LokiResearch/LagMeterUIST17/Readme.md

# Description

## electronicBoard

Contains the Eagle files to replicate the lagmeter shield for Arduino Leonardo.

A [shopping basket](http://www.digikey.fr/short/qtt791) with the list of components to buy is ready for Digikey (also available as a [CSV file](electronicBoard/digikey.csv)).

## LagmeterLeonardo

Contains the Arduino code to run on an Arduino Leonardo board with the above shield.

Requires to install [HID-Project](https://github.com/NicoHood/HID/) first.

## TurboHID

Contains C++ source code to communicate with the Arduino Leonardo using raw HID.

You have to install [libpointing](http://libpointing.org) first (used for the timestamps).

To compile the library run ```qmake && make```

On Windows, the library is provided in the external folder.

## BasicLogger

Code for logging data coming from the Arduino

Successfully compile using Qt 5.15.1 MSCV2015 64 bits in release mode.

## ReplicationCppQt && ReplicationCppGLUT

Code for producing tables 4, 5 & 6 in the paper. Compile using ```qmake && make```

Edit ```config.cfg``` to provide the URI for your mouse.

Directly pass the config file as a parameter for the GLUT application and use ```-c config.cfg``` for the Qt application.

## parser

Python code to parse the log files and compute stats.

Example: ```./parse-log --start piezo yourlogfile```

You have to correct the reported values according to what is described in the paper: "Intermediate latency values were computed by subtracting the host computer piezo time from the considered event time (libpointing, system, toolkit, repaint or screen), adding 5.7 ms and further adding 0.7 ms for the initial communication between the Arduino and the host computer." (page 5). Read the paper for more details.

## FlashApps

Code for producing Table 7 in the paper.

## UISTdemo

Android code used for the UIST demo showing the measure of latency while the user is interacting with an application. The lagmeter is connected to the Android device.

## Related publication



```
@inproceedings{10.1145/3126594.3126606,
    author = {Casiez, G\'{e}ry and Pietrzak, Thomas and Marchal, Damien and Poulmane, S\'{e}bastien and Falce, Matthieu and Roussel, Nicolas},
    title = {Characterizing Latency in Touch and Button-Equipped Interactive Systems},
    year = {2017},
    isbn = {9781450349819},
    publisher = {Association for Computing Machinery},
    address = {New York, NY, USA},
    url = {https://doi.org/10.1145/3126594.3126606},
    doi = {10.1145/3126594.3126606},
    abstract = {We present a low cost method to measure and characterize the end-to-end latency when using a touch system (tap latency) or an input device equipped with a physical button. Our method relies on a vibration sensor attached to a finger and a photo-diode to detect the screen response. Both are connected to a micro-controller connected to a host computer using a low-latency USB communication protocol in order to combine software and hardware probes to help determine where the latency comes from. We present the operating principle of our method before investigating the main sources of latency in several systems. We show that most of the latency originates from the display side. Our method can help application designers characterize and troubleshoot latency on a wide range of interactive systems.},
    booktitle = {Proceedings of the 30th Annual ACM Symposium on User Interface Software and Technology},
    pages = {29–39},
    numpages = {11},
    keywords = {toolkits, measurement tools, measure, latency, lag},
    location = {Qu\'{e}bec City, QC, Canada},
    series = {UIST '17}
}
```
