LokiResearch/LagMeterUIST17/electronicBoard/digikey.csv

Index | Quantité | Référence | Description | Référence client | Quantité disponible | Quantité d'articles différés | Prix unitaire EUR | Montant EUR
1 | 2 | PTV09A-4020F-B103-ND | POT 10K OHM 1/20W CARBON LINEAR |  | 2 | 0 | 0 | 70000 | 1 | 40
2 | 1 | 1568-1413-ND | ARDUINO STACKABLE HEADER KIT - R |  | 1 | 0 | 1 | 27000 | 1 | 27
3 | 2 | 296-1388-5-ND | IC DIFF COMP W/STROBE 8-SOIC |  | 2 | 0 | 0 | 47000 | 0 | 94
4 | 2 | MMBT2907ALT1GOSCT-ND | TRANS PNP 60V 0.6A SOT23 |  | 2 | 0 | 0 | 09000 | 0 | 18
5 | 2 | 160-1167-1-ND | LED RED CLEAR 1206 SMD | D1_2 | 2 | 0 | 0 | 31000 | 0 | 62
6 | 2 | 160-1169-1-ND | LED GREEN CLEAR 1206 SMD | D3_4 | 2 | 0 | 0 | 29000 | 0 | 58
7 | 1 | 311-100GRCT-ND | RES SMD 100 OHM 5% 1/10W 0603 | R12 | 1 | 0 | 0 | 08000 | 0 | 08
8 | 4 | 445-7534-1-ND | CAP CER 0.1UF 50V X7R 0805 |  | 4 | 0 | 0 | 10000 | 0 | 40
9 | 1 | EG1903-ND | SWITCH SLIDE SPDT 200MA 30V |  | 1 | 0 | 0 | 49000 | 0 | 49
10 | 2 | S7000-ND | CONN HEADER FEMALE 2POS .1" TIN |  | 2 | 0 | 0 | 27000 | 0 | 54
11 | 1 | 1050-1040-ND | ARDUINO LEONARDO WITH HEADERS |  | 1 | 0 | 17 | 50000 | 17 | 50
12 | 1 | PDB-C156-ND | PHOTODIODE BLUE 8.02MM SQ CLEAR |  | 1 | 0 | 1 | 43000 | 1 | 43
13 | 1 | MSP6915-ND | SENSOR MINISENSE 100 VERTICAL |  | 1 | 0 | 4 | 90000 | 4 | 90
