LokiResearch/LagMeterUIST17/electronicBoard/lagmeter-complete.brd

## EAGLE design electronicBoard/lagmeter-complete.brd (2025-10-16)

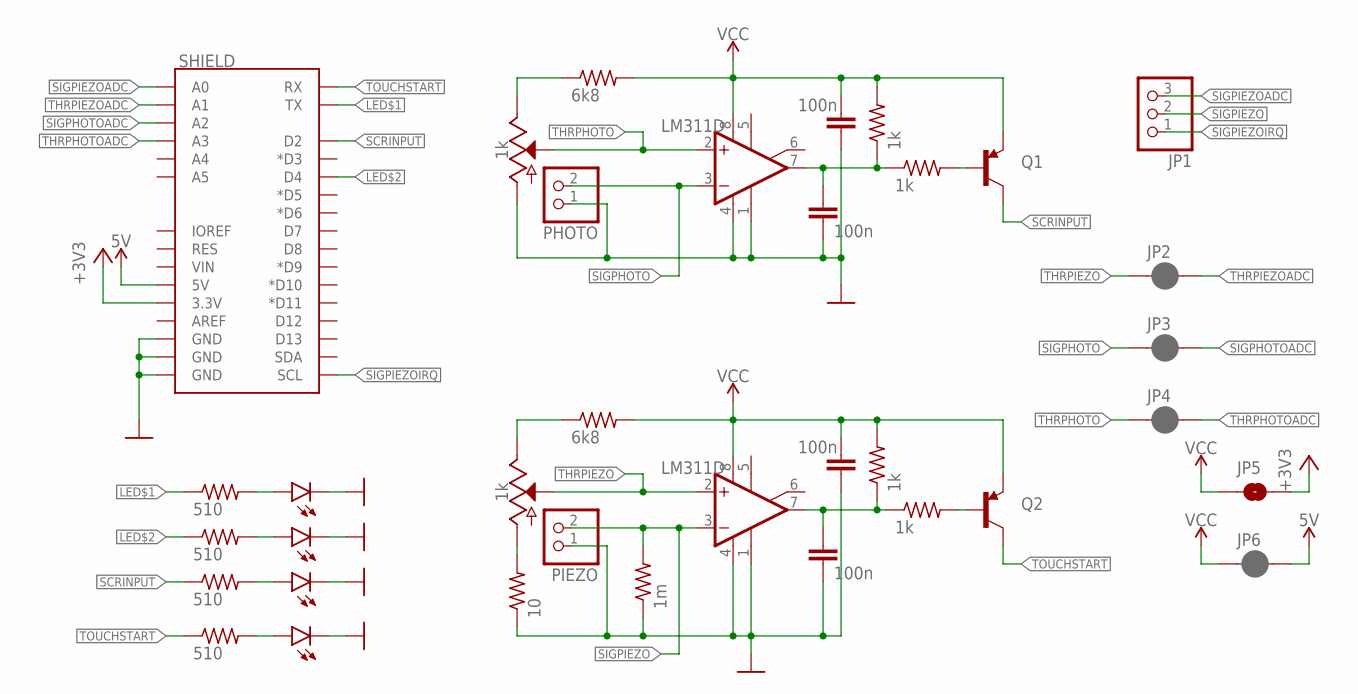
[picture p1: schematic lagmeter-complete.sch]

Parts:
C1, C2, C3, C4: 100n; C0805
D1, D2, D3, D4: LED1206; LED-1206
IC1, IC2: LM311D; SO08
JP1: PINHD-1X3; 1X03
JP2, JP3, JP4: JUMPER-SMT_2_NC_PASTE_SILK; SMT-JUMPER_2_NC_PASTE_SILK
JP5: JUMPER-SMT_2_NO_NO-SILK; SMT-JUMPER_2_NO_NO-SILK
JP6: JUMPER-SMT_2_NC_PASTE_NO-SILK; SMT-JUMPER_2_NC_PASTE_NO-SILK
PHOTO: PINHD-1X2; 1X02
PIEZO: PINHD-1X2; 1X02
Q1, Q2: TRANSISTOR_PNPSMD; SOT23-3
R1, R2: 6k8; R0603
R3, R4, R5, R6: 1k; R0603
R7, R8, R9, R10: 510; R0603
R11: 1m; R0603
R12: 10; R0603
SHIELD: ARDUINO_UNO_R3_SHIELDBASIC; UNO_R3_SHIELD
VR1, VR2: 1k; POT-PTH-ALPS

Connections:
5V: JP6.2, SHIELD.5V
+3V3: JP5.2, SHIELD.3.3V
GND: C1.2, C2.2, C3.2, C4.2, D1.C, D2.C, D3.C, D4.C, IC1.1 (GND), IC1.4 (V-), IC2.1 (GND), IC2.4 (V-), PHOTO.1, PIEZO.1, R11.1, R12.1, SHIELD.GND@0 (GND), SHIELD.GND@1 (GND), SHIELD.GND@2 (GND), VR1.P$3 (A)
LED$1: R9.1, SHIELD.TX
LED$2: R7.1, SHIELD.D4
MAXTHR: R2.1, VR2.P$1 (E)
MINTHR: R12.2, VR2.P$3 (A)
unnamed: D1.A, R9.2
unnamed: C2.1, IC1.7 (OUT), R3.1, R4.1
unnamed: D2.A, R7.2
unnamed: D3.A, R8.2
unnamed: Q1.1 (B), R3.2
unnamed: C4.1, IC2.7 (OUT), R5.1, R6.1
unnamed: Q2.1 (B), R5.2
unnamed: D4.A, R10.2
REFPHOTO: R1.1, VR1.P$1 (E)
SCRINPUT: Q1.3 (C), R8.1, SHIELD.D2
SIGPHOTO: IC1.3 (-IN), JP3.1, PHOTO.2
SIGPHOTOADC: JP3.2, SHIELD.A2
SIGPIEZO: IC2.3 (-IN), JP1.2, PIEZO.2, R11.2
SIGPIEZOADC: JP1.3, SHIELD.A0
SIGPIEZOIRQ: JP1.1, SHIELD.SCL
THRPHOTO: IC1.2 (+IN), JP4.1, VR1.P$2 (S)
THRPHOTOADC: JP4.2, SHIELD.A3
THRPIEZO: IC2.2 (+IN), JP2.1, VR2.P$2 (S)
THRPIEZOADC: JP2.2, SHIELD.A1
TOUCHSTART: Q2.3 (C), R10.1, SHIELD.RX
VCC: C1.1, C3.1, IC1.8 (V+), IC2.8 (V+), JP5.1, JP6.1, Q1.2 (E), Q2.2 (E), R1.2, R2.2, R4.2, R6.2

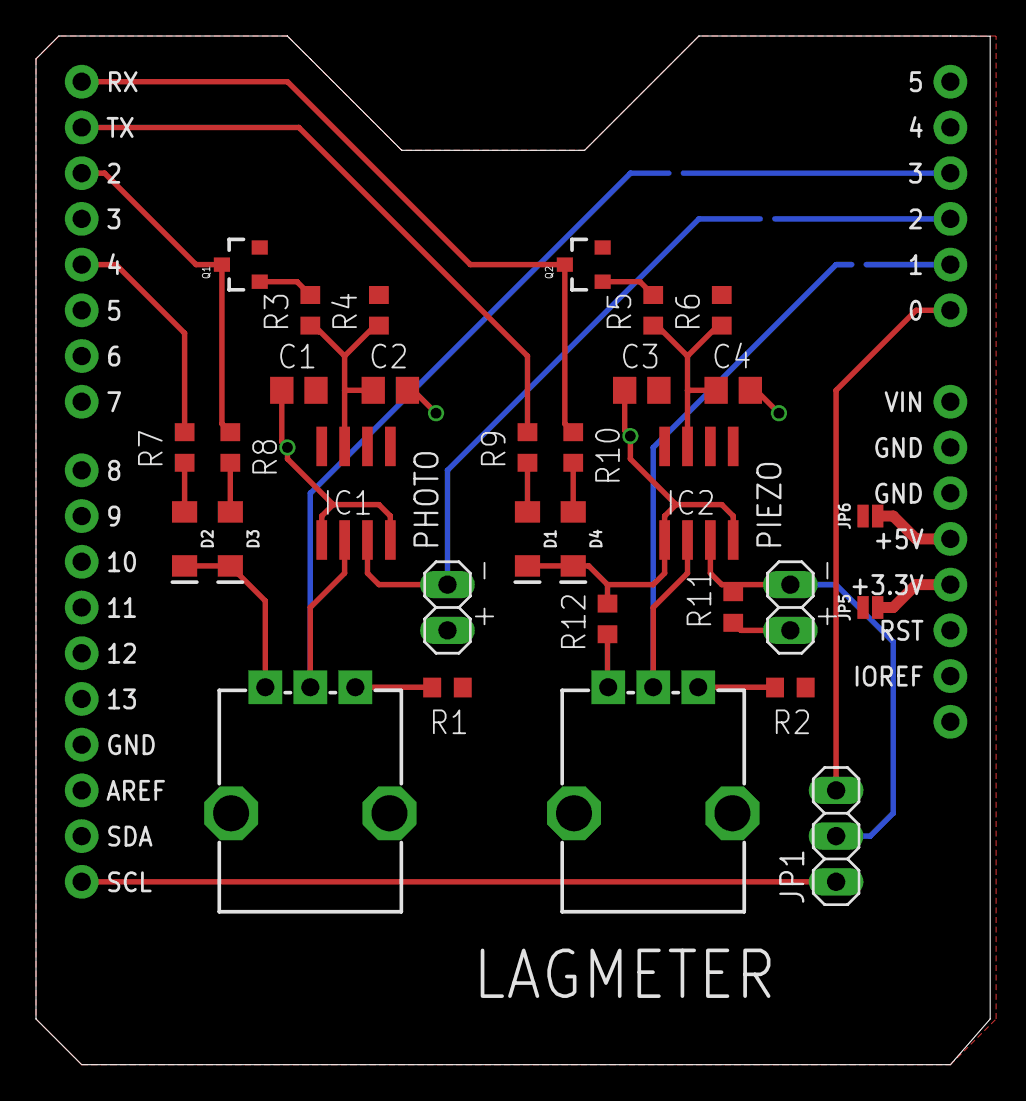
[picture p2: board lagmeter-complete.brd from above]

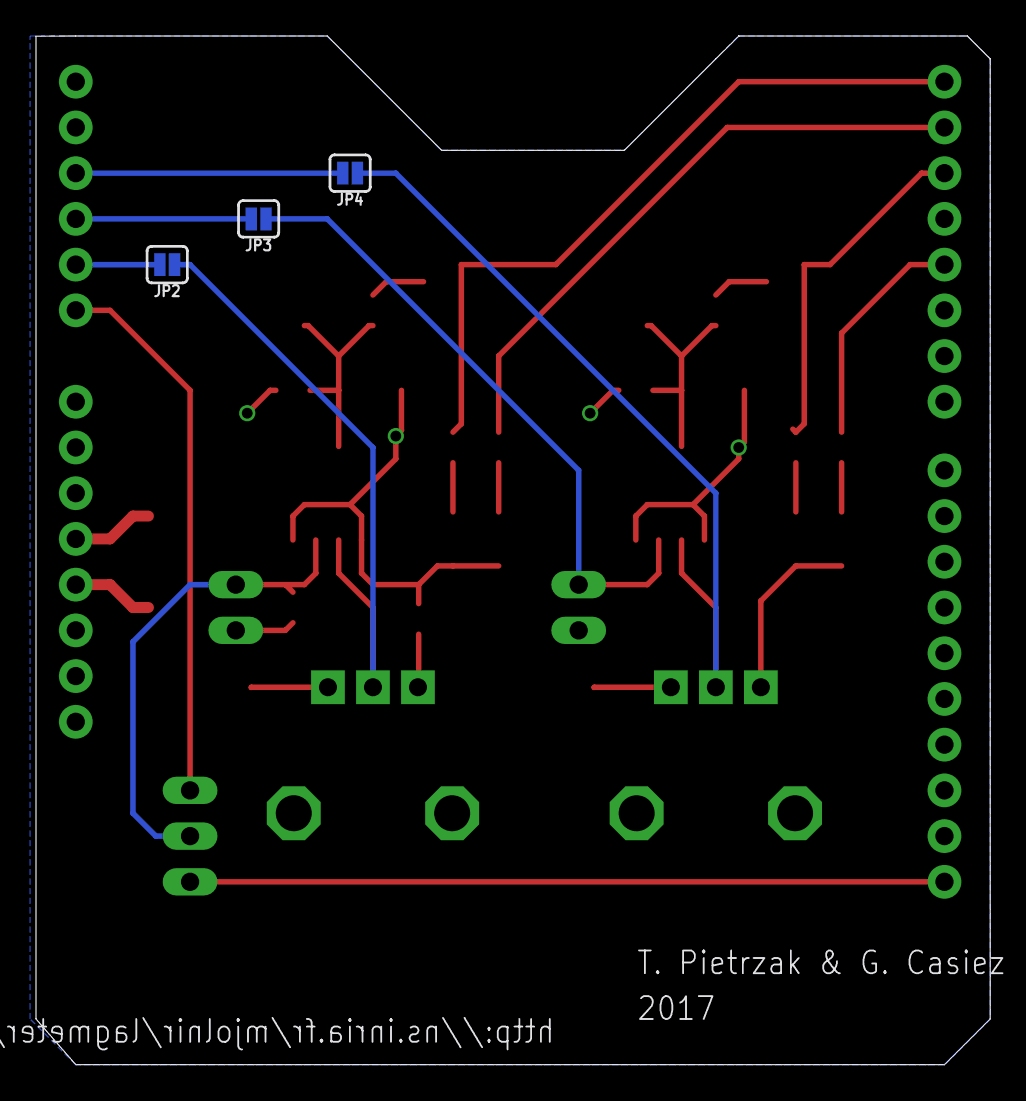
[picture p3: board lagmeter-complete.brd from below]

Board: 2 copper layers, 53.0 x 57.1 mm, 35 parts (3 on the bottom side), 28 nets.
